eMadman/NJSlowFeeder/CAD_Models/V1.2/3DPrint-Orientations.png

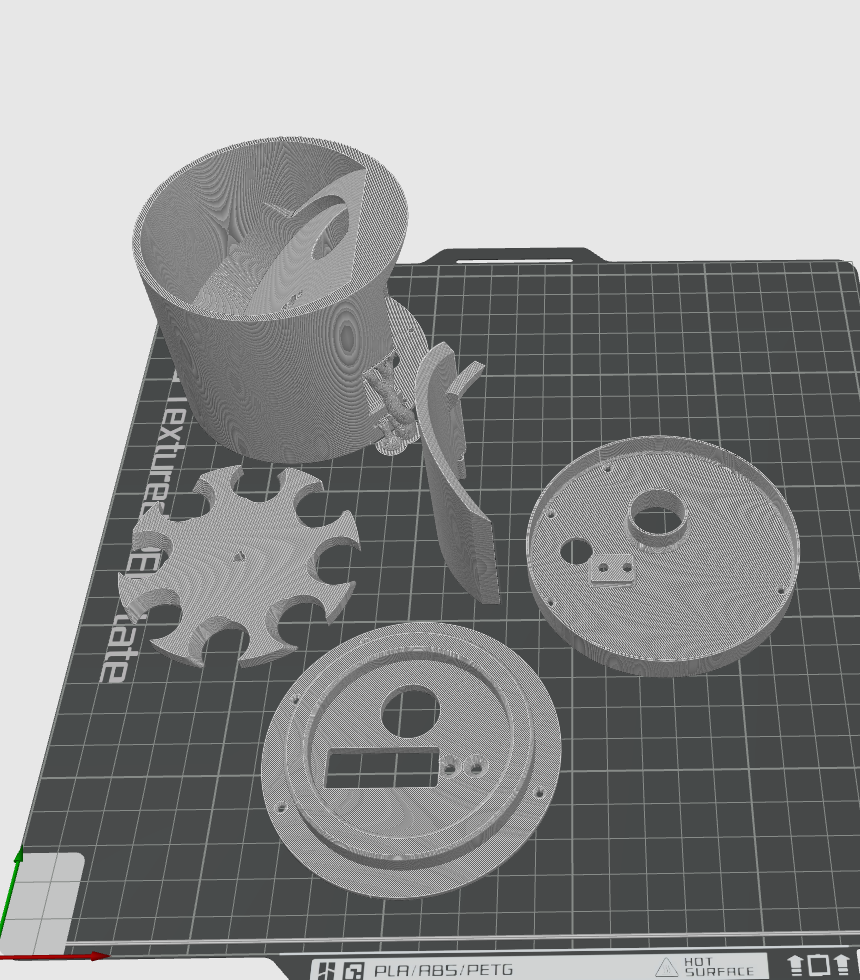
CAD_Models/V1.2/3DPrint-Orientations.png
