eMadman/NJSlowFeeder/CAD_Models/V1.2/slowfeed_nj_v1_2_1_xiao.stl

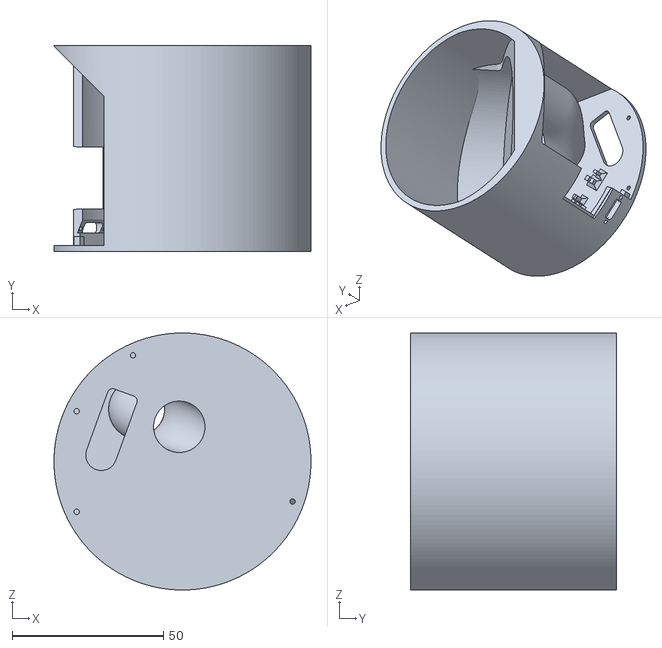
[picture p2: CAD file, 2025-07-29]
CAD_Models/V1.2/slowfeed_nj_v1_2_1_xiao.stl
85.0 x 68.0 x 85.0
