eMadman/NJSlowFeeder/CAD_Models/V1.2/Zerno Adaptors/slowfeed_zernoz1ring_WIDE_v1_2.stl

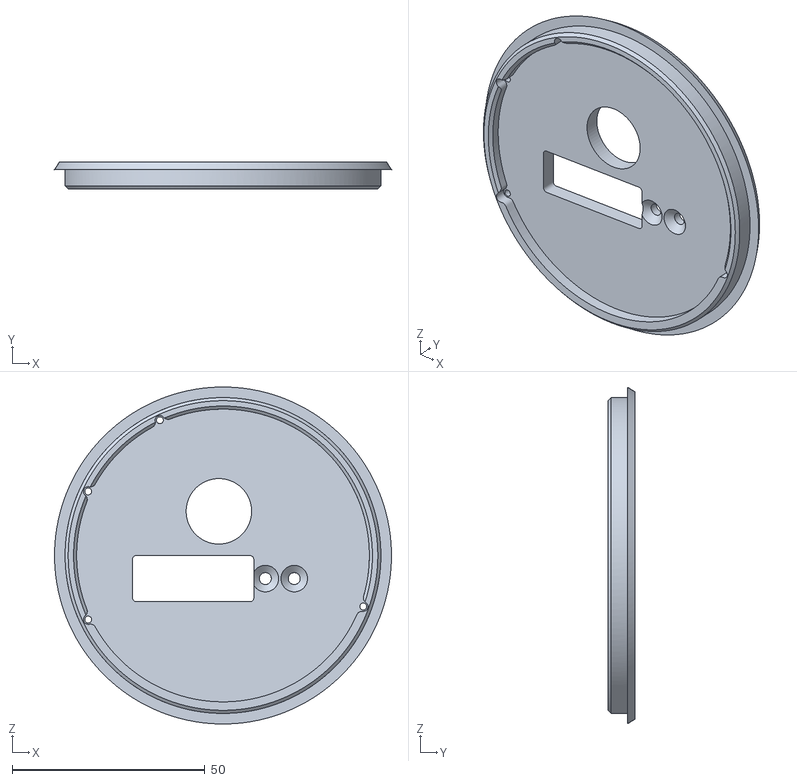
[picture p3: CAD file, 2025-07-15]
CAD_Models/V1.2/Zerno Adaptors/slowfeed_zernoz1ring_WIDE_v1_2.stl
87.5 x 7.00 x 87.5
