eMadman/NJSlowFeeder/CAD_Models/V1.2/slowfeed_loadcellring_v1_2_1.stl

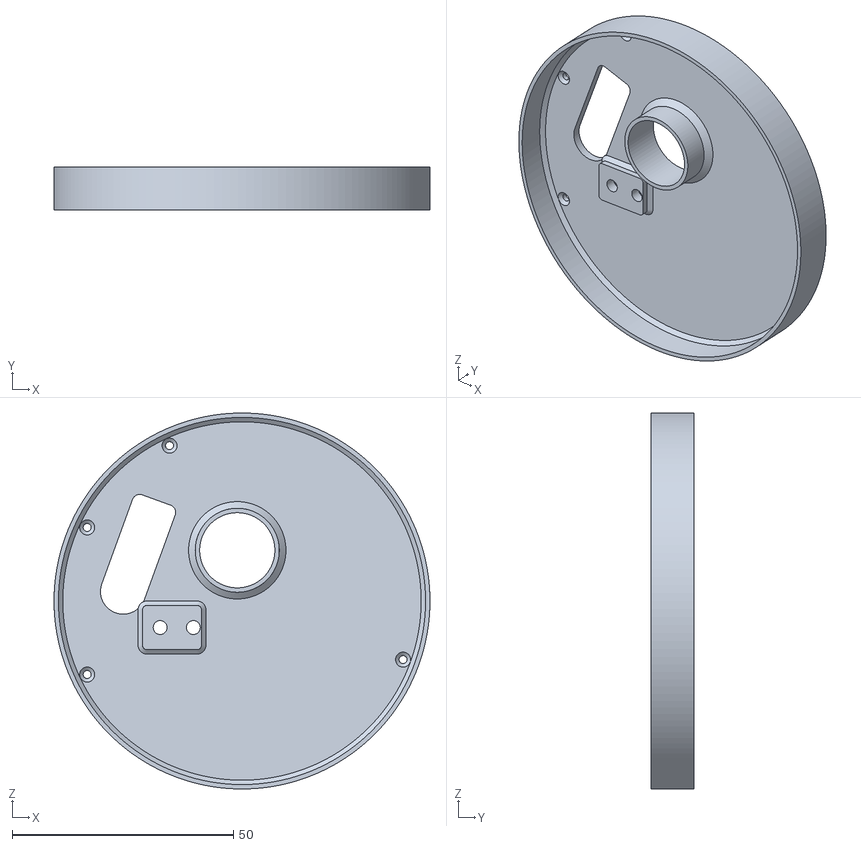
[picture p4: CAD file, 2025-07-29]
CAD_Models/V1.2/slowfeed_loadcellring_v1_2_1.stl
85.0 x 9.75 x 85.0
