eMadman/NJSlowFeeder/(list of files, cad)

Other CAD files:
CAD_Models/V1.2/slowfeed_nj_v1_2_1_supermini.stl
CAD_Models/V1.2/Archive/slowfeed_nj_v1_2_supermini.stl
CAD_Models/V1.2/Archive/slowfeed_nj_v1_2_xiao.stl
CAD_Models/V1.2/Archive/slowfeed_loadcellring_v1_2.stl
