eMadman/NJSlowFeeder/CAD_Models/V1.2/Wiring Diagram Xiao-s3-20250728.JPG

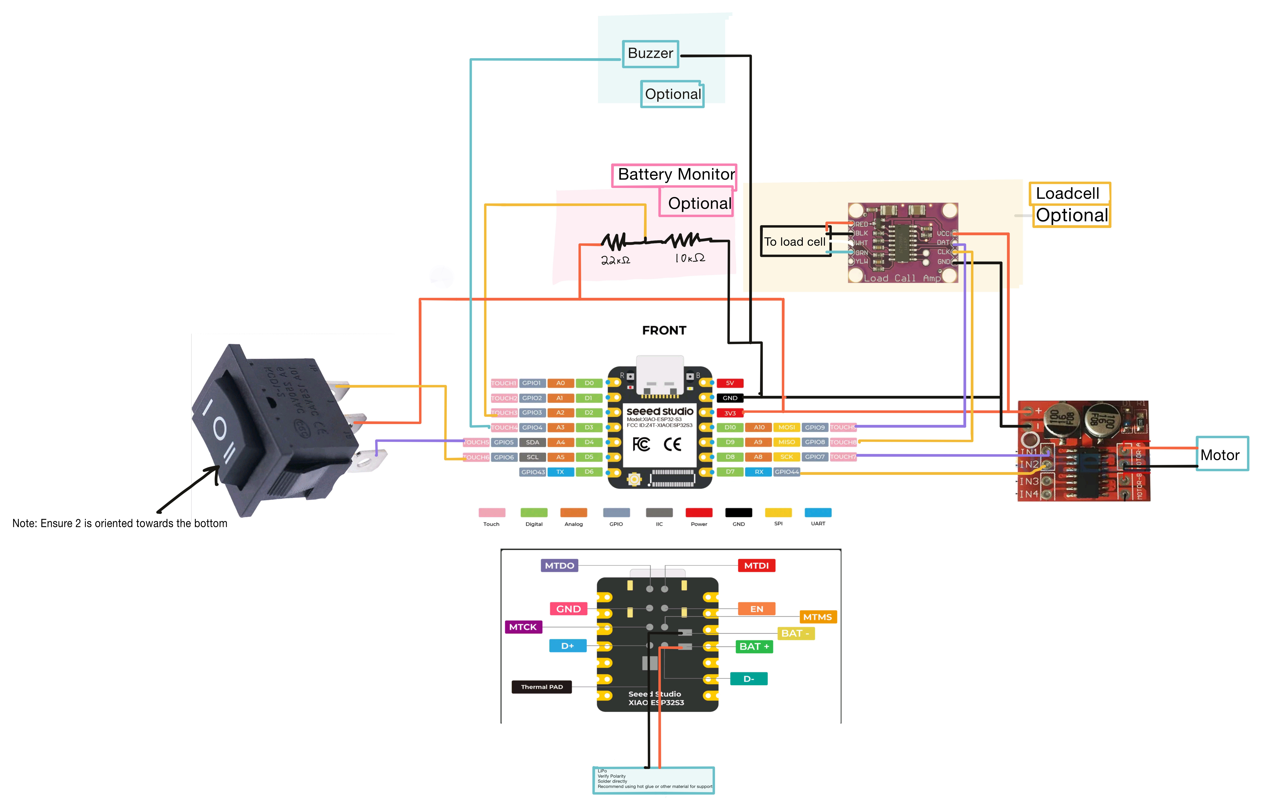
CAD_Models/V1.2/Wiring Diagram Xiao-s3-20250728.JPG
