eMadman/NJSlowFeeder/(commit log)

2025-05-18 Tie IN2 low for motor driver operation on xiao
2025-05-18 add motor pulldowns to LoadCellCalibration
2025-05-19 updates to noise indicators
    [main.cpp]
2025-06-20 corrected deep sleep behavior
    [Board.cpp, Board.h, Motor.cpp, main.cpp]
2025-06-22 add voltage divider to monitor battery level
2025-06-22 attempt to reduce battery drainage after deepsleep
2025-06-23 more power saving fix
    [Board.cpp]
2025-06-23 Add 3D print orientation image
2025-06-23 Correct button double-click logic; bug fix; code quality improvement
    [Battery.cpp, Battery.h, Board.cpp, Board.h, Motor.cpp, Motor.h, main.cpp]
2025-06-24 improve battery level reading accuracy
2025-06-26 add buzzer component; add non blocking read weight and autostop algo improvement; save motor speed in deep sleep
    [Board.cpp, Board.h, Motor.cpp, Motor.h]
2025-07-05 correct rtc motor speed tracking
    [Board.cpp, Motor.cpp]
2025-07-06 refractor motor functions for better clarity
2025-07-07 optimize battery voltage reading across devices
2025-07-15 Zerno aftermarket ring
    [slowfeed_zernoz1ring_WIDE_v1_2.stl]
2025-07-29 Update documentation, small CAD update to make loadcell removal/work easier.
    [slowfeed_loadcellring_v1_2.stl, slowfeed_loadcellring_v1_2_1.stl, slowfeed_nj_v1_2_1_supermini.stl, slowfeed_nj_v1_2_1_xiao.stl, slowfeed_nj_v1_2_supermini.stl, slowfeed_nj_v1_2_xiao.stl]
2025-08-10 Add pullup resistor to HX711 in wiring diagram
